emanuel-gold/WebTurntable/STL/bottom plate.stl

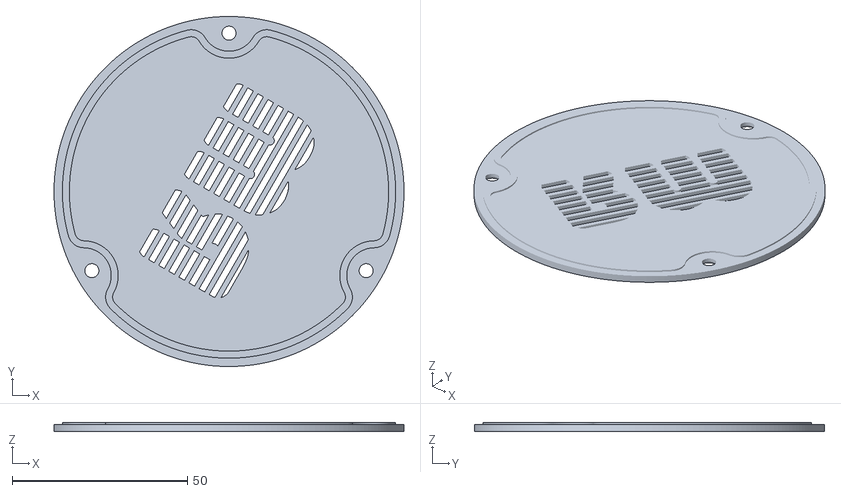
[picture p1: CAD file, 2026-10-13]
STL/bottom plate.stl
100.0 x 100.0 x 2.50
