emanuel-gold/WebTurntable/STL/body.stl

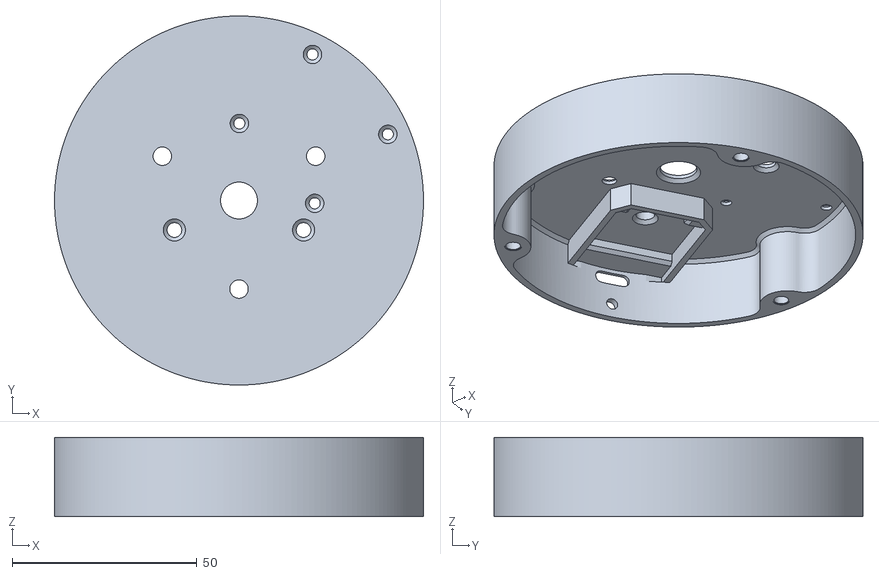
[picture p2: CAD file, 2026-10-13]
STL/body.stl
100.0 x 100.0 x 21.5
