emanuel-gold/WebTurntable/STL/top plate.stl

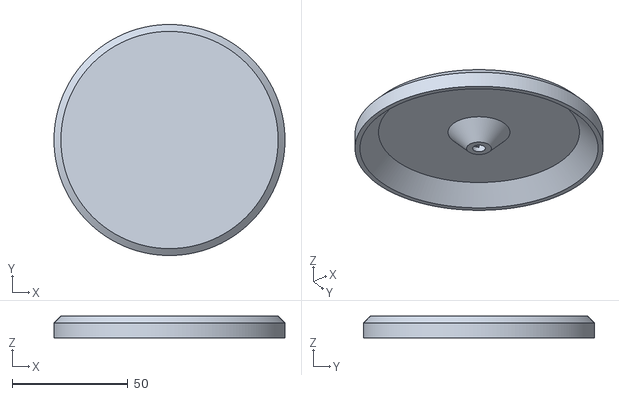
[picture p3: CAD file, 2026-10-13]
STL/top plate.stl
100.0 x 100.0 x 9.50
