emanuel-gold/WebTurntable/(commit log)

2026-10-13 committing original STL files
    [body.stl, bottom plate.stl, top plate.stl]
2026-10-13 Add v2 (ESP32) roadmap, design docs, and CLAUDE.md
    Plan the move from the ESP8266 D1 mini to an ESP32 DevKit V1 with
    smoother timer-driven motion, angle control, sweep/timer/presets and a
    Bluetooth camera shutter, plus an enclosure riser for the DevKit.
    - CLAUDE.md: project context, session-start steps, per-PC tooling notes
    - docs/ROADMAP.md: status, phases, MVP scope, backlog, decisions, open questions
    - docs/FIRMWARE.md: v2 architecture, motion engine, WebSocket protocol draft
    - docs/HARDWARE.md: parts, ESP32 pin map, wiring, power
    - docs/ENCLOSURE.md: measured STL geometry and the v2 riser-ring design
    - tools/stl_inspect.py: numpy-only STL measuring/slicing tool
    - .gitignore: Python venv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
2026-10-14 Add arduino-cli build profile pinning the ESP32 toolchain
    The esp32 profile pins core 3.3.12, ESP Async WebServer 3.12.1,
    Async TCP 3.5.0 and ArduinoJson 7.4.3, with the Minimal SPIFFS
    partition scheme, so v2 can be compile-checked the same way on
    either PC.
2026-10-14 Add a dependency-free mock server for UI work without hardware
    tools/mock-server serves data/ and emulates the v1 WebSocket protocol
    at /ws, using only Node built-ins. The UI now builds its WebSocket URL
    from location.host so it keeps the mock's port; on the device the
    port is 80, so nothing changes there.
2026-10-14 Add a flash script and a step-by-step flashing guide
    tools\flash.cmd compiles and flashes v2 with arduino-cli and the pinned
    profile: firmware, web UI (mklittlefs + esptool, offset and size read
    from the partition table), serial monitor, and port listing. It only
    auto-picks USB serial ports, never Bluetooth ones, and -WhatIf skips
    the writes. docs/FLASHING.md covers setup, commands and
    troubleshooting.
    Also notes that a web UI upload erases LittleFS, which matters for
    where Phase 3 keeps presets, and that work now happens on master.
2026-10-14 Record the Phase 0 answers and finish Phase 0
    30-pin DevKit dimensions and mounting holes, a Dupont harness plan,
    micro-USB through the riser (USB-C moves to the backlog), iPhone 16
    as the shutter test phone, and ESP8266 frozen at v1-esp8266. The
    open questions are now the two measurements Phase E still needs.
2026-10-15 Port the firmware to the ESP32 DevKit (Phase 1)
    Same features and protocol as v1, now on the ESP32:
    - ESP32 pin map (IN1-IN4 on GPIO 33/25/26/27, status LED on 23),
    WiFi.h and AsyncTCP.
    - Fix the CCW mismatch: RotateDirection::CCW is now 2, the value the
    UI sends.
    - Settings move from a LittleFS file to NVS (Preferences), so web UI
    uploads keep them. The 750 ms debounce stays.
    - ArduinoJson 7 replaces Arduino_JSON, with explicit range checks.
    - The save flag is an atomic, cleared before the snapshot is taken,
    because AsyncTCP callbacks can run on the other core.
    - Clean up stale WebSocket clients once a second.
    - Separate startup errors for an unmounted file system and a missing
    we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
    [WebTurntable.ino, server.cpp, server.h]
2026-10-15 Port the Basic sketch as a motor-only wiring test
    Basic now uses the ESP32 pins, lights the status LED, and has its own
    build profile. tools\flash.cmd firmware -Sketch code\Basic flashes it.
    The flash script also checks that the sketch folder exists and skips
    the 'Done' line in -WhatIf runs.
    [Basic.ino]
2026-10-15 Update README and docs for Phase 1
    README build instructions now cover the ESP32 and tools\flash.cmd.
    FLASHING.md gains a first-flash checklist and a motor test. Records
    the Dupont stack (22 mm plus bend, riser about 31 mm), the Ø3 mounting
    holes and the Phase 1 decisions. Phase 1 is ticked pending the
    hardware test.
2026-10-15 Move the access point to 192.168.4.5
    The ESP32 default, 192.168.4.1, is the user's home router address.
    softAPConfig runs before softAP, so DHCP hands out leases from
    192.168.4.6.
2026-10-15 Document the new AP address and the BOOT-button finding
    The DevKit needs BOOT held to enter download mode, which matters once
    it's enclosed. Records the options (EN capacitor, access holes, Wi-Fi
    updates) as an open question. Adds troubleshooting for the sync and
    network errors, and updates the Phase 1 status: flashed, UI test
    pending.
2026-10-15 Record Phase 1 test results and the auto-reset diagnosis
    The UI loads at 192.168.4.5 and turntable.local, and settings survive a
    power cycle. Custom esptool reset sequences show this DevKit's DTR line
    never pulls GPIO0 low, so hands-free flashing needs a different board,
    not a capacitor.
2026-10-15 Add the timer-driven motion engine and protocol v2 (Phase 2)
    motion.cpp: a GPTimer ISR on core 1 steps the coils through the GPIO
    registers, counts position in half-steps (positive clockwise) and stops
    exactly on move targets. A 1 kHz control task ramps the velocity
    (trapezoidal accel and decel, braking at v^2/2a), and handles half- and
    two-phase full-step modes. Coils switch off when idle.
    server.cpp speaks protocol v2: speed, run, stop, halt, moveBy, moveTo
    (shortest, cw, ccw), setZero and settings, with a full state broadcast
    after each command and at 10 Hz while moving. The AsyncTCP task only
    parses and validates; commands are queued and run in loop(). Settings
    (TTB2) wait for idle befo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
    [WebTurntable.ino, config.h, motion.cpp, motion.h, server.cpp, server.h]
2026-10-15 Rework the web UI for protocol v2
    Live angle dial, an RPM speed slider with seconds per revolution, CW
    and CCW buttons, position tools (+/-15/45/90, Rotate by, Go to angle
    with direction, Set zero), a settings panel (drive mode, acceleration,
    max speed) and an always-visible STOP; a second tap while stopping
    halts. Inputs being edited aren't overwritten by incoming state.
2026-10-15 Mock server: emulate protocol v2 with a simulated motion engine
    protocol-v2.js mirrors server.cpp's parsing and motion.cpp's ramps, so
    the UI sees realistic motion. protocol-v1.js is gone with the v1 UI.
    Tests cover errors, clamping, moves, shortest-path Go to, spinning,
    Set zero, and 24 x 15 deg nudges landing without drift.
2026-10-15 Document Phase 2 and close Phase 1
    FIRMWARE.md now describes the motion engine and protocol as built.
    FLASHING.md gains Phase 2 hardware checks (smoothness, 360 return,
    10-revolution test, max speed, two phones). The roadmap closes Phase 1,
    ticks the Phase 2 code items, records the decisions, and defers the
    BOOT-button question.
2026-10-16 adding backlog item: continuous RPM adjust while motor is spinning
2026-10-16 Roadmap: add Phase W (home Wi-Fi with captive-portal setup)
    Revives the captive portal for setup, records the user's flow (setup AP
    with a captive page, LAN client when a known network exists, AP-only as
    a non-persistent fallback, reset to re-run setup) and adds a Wi-Fi
    status LED as a non-blocking item. Open details are marked proposed.
2026-10-16 Join home Wi-Fi, with a captive-portal setup access point (Phase W)
    wireless.cpp runs the connection as a state machine in loop():
    - With a saved network, it connects as a LAN client and runs no
    access point. A drop just reconnects.
    - With no saved network, it starts the open TURNTABLE access point
    (192.168.4.5) with captive DNS and the setup page. The same happens
    if the saved network isn't found within 20 s, in which case it
    keeps retrying that network every minute while no phone is on the
    setup network.
    - A network picked on the setup page is saved only once it connects.
    The access point then stays up for 30 s so the page can show the
    address.
    - "Use Turntable as an access p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
2026-10-16 Add the Wi-Fi setup page and a Wi-Fi row in settings
    setup.html/setup.js: scan list (strongest first, lock and signal bars),
    Other network, password with show toggle, progress while joining, the
    new address on success, and Use Turntable as an access point. The
    control page shows the network, address and signal, and has a two-tap
    Change Wi-Fi network button.
2026-10-16 Mock server: emulate Wi-Fi setup
    --wifi setup starts the mock in setup mode. protocol-v2.js answers the
    setup routes (scan, join, ap, status), reports wifi in the state, and
    handles wifiSetup by dropping clients like a restart. The password
    'wrongpassword' fails. Eight new tests cover the flow.
2026-10-16 Document Phase W: connecting, the reset button, and setup internals
    FLASHING.md explains first-time setup, everyday use, access point mode
    and switching networks, with new troubleshooting rows. HARDWARE.md adds
    the GPIO 22 reset button to the parts, pin map and harness. FIRMWARE.md
    documents the Wi-Fi states, captive portal and setup API. The roadmap
    ticks Phase W's code items and records the decisions.
2026-10-21 Roadmap: record the Phase 2 and Phase W hardware results
    Positioning stops short by roughly 2 degrees per revolution at both
    speeds tested, pointing at the steps-per-revolution constant (likely the
    64:1 motor variant). Phase W setup, reconnect, fallback and Change
    Wi-Fi all passed; the reset button and access point mode are still to
    test. Moves don't follow the speed slider live; spins do.
2026-10-21 Roadmap: access point mode passed; record the resume-on-power-up problem
    A spin saved before a power cut restarts at power-up before any control
    page is reachable, so it can't be stopped until Wi-Fi reconnects.
2026-10-21 Never restart a spin after a power loss
    A spin saved before a power cut restarted at power-up, before any
    control page was reachable (in testing it couldn't be stopped until
    Wi-Fi reconnected). spinning is now runtime-only: cleared at load, and
    the save-before-spinning exception is gone. Speed and the other settings
    are still restored.
2026-10-21 Make the CW and CCW buttons press-to-toggle
    Pressing the direction that's already spinning sends stop (ramped);
    pressing the other direction, or either while stopping, spins. The
    buttons look the same.
2026-10-21 Move the status LED to GPIO 2 and the reset button to GPIO 4; save spins
    D4, D2, D15 and GND sit in a row, so one 4-pin housing carries the
    button and LED (D15 empty), instead of leads from the far corner of
    the board. D5 was ruled out: it's a strapping pin that outputs during
    boot, and the reset button is held at power-up.
    Settings now also save while a spin runs, so a speed change mid-spin
    survives a power cut (found in testing). Moves still wait for idle,
    because flash writes pause stepping.
2026-10-21 Calibrate to the 64:1 motor, cap speed at 25 RPM, note the iOS sheet quirk
    The 10-revolution test stopped about 18.5 mm short at the 50 mm rim
    (about 2.1 deg per revolution), which works out to about 4100 half-steps per revolution:
    the exact 64:1 variant (4096), not the datasheet's 63.684:1.
    HALF_STEPS_PER_REV is now 4096, pending a rerun.
    Max speed tests: 25 RPM is clean in half-step, full-step stalls at 25,
    and both stall at 30. MAX_RPM_LIMIT is 25 and DEFAULT_MAX_RPM 20.
    iOS may not reopen the captive sheet when rejoining a known network;
    FLASHING.md lists the workarounds.
    [config.h]
2026-10-21 Cap max speed at 20 RPM
    The user doesn't need more than 20. Half-step tested clean to 25 and
    full-step stalled at 25, so 20 also leaves margin.
    [config.h]
2026-10-21 Clamp the max speed and acceleration inputs to their limits
    Out-of-range values are pulled back into range in the page, with a note
    saying so, instead of being sent and quietly clamped by the firmware.
2026-10-21 Close Phases 2 and W
    All hardware checks passed: the 64:1 calibration (3600 deg lands on the
    mark), the 20 RPM cap, no spin after a power loss, the CW/CCW toggle,
    Wi-Fi setup, the fallback, the reset button and access point mode.
    Backlash compensation, the Wi-Fi status LED and PWM microstepping move
    to the backlog. Also fixes a garbled tools\flash.cmd path in the
    status.
2026-10-21 UI for sweeps, stop conditions and presets
    The Spin card becomes a Motion card with Spin and Sweep tabs over the
    shared speed slider. Spin gets "Run until STOP / N revolutions /
    T minutes"; Sweep gets From and To angles with a plain-language summary,
    the pause at each end, its run length, and a Start/Stop sweep button.
    The line under the angle shows what's left (revolutions, cycle N of M,
    or time). A job started from any phone brings its tab forward.
    A Presets card lists saved presets with a summary. Tapping one loads it
    and switches to its tab; nothing moves until Start. Delete takes two
    taps. Option fields are sent as they change, so every phone shows them
    and they're saved, and Start and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
2026-10-22 Close Phase 3
    All hardware checks passed: counted and timed spins, live speed during a
    move, a 3-cycle sweep ending on From, the iPhone minus sign, presets
    surviving a power cycle and a web UI upload, and two phones staying in
    step. Next is Phase 4, the Bluetooth shutter.
2026-10-22 Phase 4 firmware: Bluetooth shutter, photo and video capture
    Shutter (shutter.cpp): NimBLE-Arduino 2.5.1 advertises a BLE remote,
    "Turntable Shutter", with Just Works pairing and bonding. Its HID report
    is consumer control only (Volume Up and Down), so iOS keeps its
    on-screen keyboard. A press is held 60 ms, short enough that the camera
    doesn't start QuickTake. NimBLE adds 253 KB of flash (68% of the app
    slot) and about 10 KB of static RAM; free heap is logged at boot.
    Captures (sequencer.cpp) run on top of the motion jobs:
    - Photo: N shots a step apart, a settle before each and a wait after,
    then back to the start the short way. Pause and resume. With no phone
    ready for a press, it pau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
    [WebTurntable.ino, config.h, presets.cpp, presets.h, sequencer.cpp, sequencer.h, server.cpp, shutter.cpp]
2026-10-22 UI for photo and video capture and the Bluetooth shutter
    Four tabs now: Spin, Sweep, Photo and Video.
    - Photo: shots and step (typing the shots fills in the step for one
    full turn), settle and after-shot waits, direction, return to start,
    a dry-run switch, the start delay, and an estimate of the total time.
    Start becomes Pause and Resume while it runs.
    - Video: spin or sweep (from those tabs, summarised here), direction,
    lead-in, lead-out, delay, and how long the video will be.
    - The line under the angle shows the countdown, the shot, the time
    left, or the recording stage.
    The shutter shows as a pill in the header and a status line with a Test
    button on both capture tabs. Settings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
2026-10-22 Document Phase 4 and add its hardware checks
    Roadmap: Phase 4 items ticked pending the hardware test, with the spike's
    result (NimBLE-Arduino 2.5.1, 68% of the app slot) and the decisions:
    consumer-control remote, presets for all four modes, linked shots and
    step, STOP ending a recording, the start delay, the separate capture
    settings blob. FIRMWARE.md covers captures, the shutter, the new
    protocol and storage. FLASHING.md gets the Phase 4 hardware checks and
    pairing troubleshooting. The mock README covers the fake shutter.
